leojpr770/CubeSat-UD34-Pr-ctica-3-de-Dise-o-de-productos/README.md

# CubeSat-UD34-Pr-ctica-3-de-Diseño-de-productos
Desarrollo de una satetile

Diagrama editables:
https://canva.link/5yh8kp0bcqomga4

### Actualizacion:
Se realizo la seleccion y la arquitecctura de la PCB OBS+ADCS, en el que se busco sus respectivos componentes y parametros. A partir de eso creamos un esquemeaticos con cierta secmentacion para cada tares de la PCB de forma jerarjica.
