leojpr770/CubeSat-UD34-Pr-ctica-3-de-Dise-o-de-productos/Hoja_de_datos.pdf

Table 1: Hojas de datos y fuentes t´ecnicas – CubeSat UD34, Pr´actica 3

Componente | Fabricante | Referencia /
modelo
Documento | Enlace

Sensor de imagen

OmniVision | OV5647 | Product datasheet (5
MP, 1.4 µm OmniBSI)

https://static.
sparkfun.com/
datasheets/Dev/
RaspberryPi/OV5647.
pdf (https://static.sparkfun.com/datasheets/Dev/RaspberryPi/OV5647.pdf)

Transceptor
UHF

onsemi (ex ON
Semiconductor)
AX5043 | Datasheet – Advanced
ASK/FSK/GFSK/MSK
Narrow-band
Transceiver

https://www.onsemi.
com/pdf/datasheet/
ax5043-d.pdf (https://www.onsemi.com/pdf/datasheet/ax5043-d.pdf)

Microcontrolador
(OBC)

STMicroelectronicsSTM32L4S5 / L4S7 / L4S9

Datasheet – Ultra-lowpower Arm Cortex-M4
MCU

https://st.
com/resource/
en/datasheet/
stm32l4s5ai.pdf (https://st.com/resource/en/datasheet/stm32l4s5ai.pdf)

Magnet´ometro
3 ejes

PNI Sensor Corporation

RM3100 | RM3100 & RM2100
Sensor Suite User Manual

https://wmsc.
lcsc.com/wmsc/
upload/file/pdf/
v2/lcsc/2001040306_
PNI-C464558_C464558.
pdf (https://wmsc.lcsc.com/wmsc/upload/file/pdf/v2/lcsc/2001040306_PNI-C464558_C464558.pdf)

IMU (giroscopio
+ aceler´ometro)
Bosch Sensortec | BMI088 | Datasheet – 6-axis IMU
de alto desempe˜no

https://www.
bosch-sensortec.com/
media/boschsensortec/
downloads/datasheets/
bst-bmi088-ds001.pdf (https://www.bosch-sensortec.com/media/boschsensortec/downloads/datasheets/bst-bmi088-ds001.pdf)

Celda de bater´ıa
Li-ion 18650
Panasonic | NCR18650B | Datasheet – especifi-
caciones y curvas de
carga/descarga

https://e2e.ti.com/
cfs-file/__key/
communityserver-discussions-components-files/ 196/
Panasonic-NCR18650B-datasheet.
pdf (https://e2e.ti.com/cfs-file/__key/communityserver-discussions-components-files/196/Panasonic-NCR18650B-datasheet.pdf)

Est´andar
mec´anico Cube-Sat
The | CubeSat
Program, | Cal
Poly SLO

CDS Rev. 13 CubeSat Design Specification

https://www.unoosa.
org/documents/pdf/
psa/hsti/KiboCUBE/
CubeSat_Design_
Specification.pdf (https://www.unoosa.org/documents/pdf/psa/hsti/KiboCUBE/CubeSat_Design_Specification.pdf)

1
