leojpr770/CubeSat-UD34-Pr-ctica-3-de-Dise-o-de-productos/Diagramas.pdf

Diagrama funcional de referencia (común a ambas alternativas)

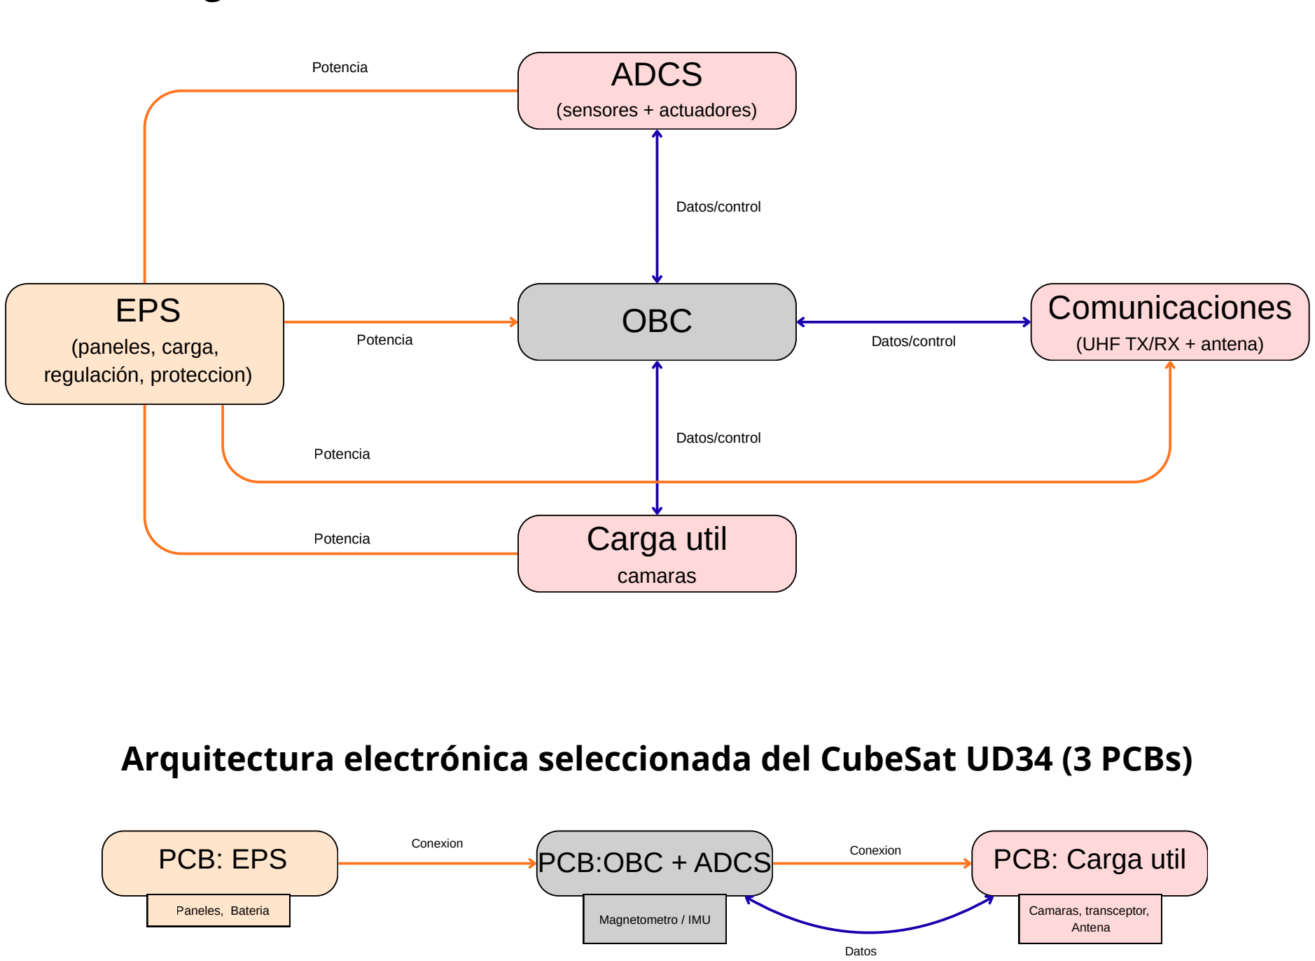
[picture p1: figure]
PCB: EPS; PCB:OBC + ADCS; PCB: Carga util; Paneles, Bateria; Camaras, transceptor,; Antena; Magnetometro / IMU; Datos Conexion; Conexion EPS; OBC; (paneles, carga, regulación, proteccion); Comunicaciones; (UHF TX/RX + antena); Datos/control Potencia; ADCS; (sensores + actuadores); Carga util; camaras; Potencia Potencia; Datos/control

Arquitectura electrónica seleccionada del CubeSat UD34 (3 PCBs)
