leojpr770/CubeSat-UD34-Pr-ctica-3-de-Dise-o-de-productos/Tablas_CubeSat.xlsx

Sheet: Requisitos
ID | Tipo | Requisito | Justificación | Prioridad | Criterio de aceptación
RF-01 | Funcional | El sistema deberá capturar imágenes en al menos 4 bandas espectrales (azul ~470 nm, verde ~550 nm, rojo ~660 nm, NIR ~850 nm). | Misión: análisis de vegetación cafetera (índices tipo NDVI) | Alta | Curvas de transmisión de los filtros y respuesta espectral del sensor en hoja de datos
RF-02 | Funcional | El sistema deberá producir imágenes con una distancia de muestreo en tierra (GSD) ≤ 20 m/píxel en nadir desde 550 km. | Misión: distinguir lotes/regiones, no plantas individuales | Alta | Cálculo GSD = (h × pixel_pitch)/f a partir de hoja de datos del sensor y la óptica
RF-03 | Funcional | El sistema deberá almacenar a bordo al menos 5 capturas multiespectrales completas antes de requerir descarga. | Disponibilidad de solo ~1 paso útil/día (S-02) | Alta | Cálculo de capacidad de memoria vs. tamaño de captura comprimida
RF-04 | Funcional | El hardware de actitud deberá permitir estimar la orientación y generar par de control suficiente para lograr apuntamiento nadir aproximado (≤ 5° en régimen estable). | Necesidad de apuntar la cámara a la Tierra | Alta | Verificación de rango dinámico de sensores y par máximo de actuadores vs. inercia estimada del 1U
RF-05 | Funcional | El sistema deberá transmitir telemetría (tensiones, corrientes, temperaturas, estado de subsistemas) en cada contacto con tierra. | Operación y supervisión | Alta | Trama de telemetría definida y verificable por radio de prueba en banco
RF-06 | Funcional | El sistema deberá recibir y decodificar comandos desde la estación terrestre (enlace de subida). | Operación remota | Alta | Prueba de recepción/decodificación en banco con transceptor de referencia
RF-07 | Funcional | El sistema de potencia deberá generar, almacenar, convertir y distribuir la energía necesaria para todos los subsistemas durante el ciclo órbita/eclipse. | Autonomía energética | Alta | Balance energético: generación orbital promedio ≥ consumo orbital promedio con margen ≥ 30 %
RF-08 | Funcional | El sistema de potencia deberá proteger los circuitos ante sobrecorriente, sobrecarga y descarga profunda de la batería. | Seguridad del hardware | Alta | Verificación de umbrales de protección en hoja de datos del IC de gestión de batería
RF-09 | Funcional | El sistema deberá permitir detumbling (reducción de velocidad angular) tras la separación del desplegador mediante los actuadores magnéticos seleccionados. | Condición inicial tras eyección | Media | Cálculo de par magnético disponible vs. velocidad angular típica de eyección (≤ 5°/s)
RF-10 | Funcional | El sistema deberá proveer una interfaz de programación/depuración accesible para cada microcontrolador antes de la integración final. | Facilidad de prueba e integración | Media | Presencia de conector/cabezal SWD o JTAG en cada tarjeta
RNF-01 | No funcional | El consumo promedio orbital del sistema no deberá superar el 70 % de la energía promedio generada. | Margen de diseño | Alta | Comparación de presupuesto de potencia
RNF-02 | No funcional | La potencia pico instantánea no deberá superar la capacidad de descarga continua de la batería seleccionada. | Protección de la batería | Alta | Comparación contra hoja de datos de la celda (corriente máx. de descarga)
RNF-03 | No funcional | El procesador central deberá tener margen de cómputo y memoria RAM ≥ 50 % sobre lo estimado para las tareas identificadas. | Evitar cuellos de botella para el software futuro | Media | Comparación de hoja de datos del MCU vs. estimación
RNF-04 | No funcional | La masa total de la electrónica (tarjetas, baterías, arnés) no deberá superar 500 g dentro del presupuesto de masa 1U. | Dejar margen para estructura, óptica y paneles | Media | Suma de masas estimadas por tarjeta
RNF-05 | No funcional | Cada PCB deberá encajar dentro del área útil de un 1U (aprox. 90 mm × 90 mm) respetando los rieles mecánicos. | Restricción mecánica del estándar CubeSat | Alta | Verificación dimensional del footprint de cada tarjeta
RNF-06 | No funcional | El enlace de comunicaciones deberá mantener un margen de enlace ≥ 3 dB en el peor caso (máxima distancia oblicua, elevación mínima de operación). | Confiabilidad del enlace | Alta | Cálculo del presupuesto de enlace
RA-01 | Ambiental | La electrónica deberá operar de forma continua en un rango de temperatura interna estimado entre -10 °C y +40 °C. | Ambiente térmico típico interno de un 1U sin control térmico activo | Media | Verificación del rango de temperatura de operación en hojas de datos de todos los componentes activos
RA-02 | Ambiental | Los componentes seleccionados deberán ser aptos para vacío (sin materiales con alto outgassing) en la medida de la información disponible del fabricante. | Ambiente de vacío en LEO | Media | Revisión de notas de aplicación/certificaciones de los fabricantes cuando existan
RA-03 | Ambiental | El sistema deberá incorporar un mecanismo de recuperación automática (watchdog + reinicio) ante fallos no catastróficos atribuibles al entorno de radiación. | Mitigación simplificada de radiación (sin calificación formal) | Media | Verificación de temporizador watchdog independiente en el diseño del OBC
RA-04 | Ambiental | La integración mecánica deberá seguir lineamientos generales de un desplegador tipo CubeSat (sujeción de tarjetas, ausencia de partes sueltas). | Cargas de lanzamiento (sin ensayo formal de vibración) | Baja | Revisión visual del modelo 3D contra lineamientos generales del estándar
RN-01 | Normativo | El CubeSat deberá respetar el sobre mecánico y el límite de masa de un 1U según la especificación de diseño CubeSat de referencia. | Compatibilidad con desplegadores estándar | Alta | Verificación dimensional y de masa contra el estándar de referencia
RN-02 | Normativo | El enlace de radiofrecuencia deberá operar en una banda permitida para el servicio de satélites de aficionados/experimental (p. ej. banda UHF 435--438 MHz), sujeto a coordinación de frecuencia. | Cumplimiento regulatorio de espectro | Alta | Verificación de la banda seleccionada contra la asignación vigente y evidencia de que se requiere coordinación
RN-03 | Normativo | La energía almacenada en la batería no deberá exceder los límites de seguridad típicamente exigidos por los desplegadores estándar para celdas de ion-litio comerciales. | Seguridad para el vehículo de lanzamiento | Media | Verificación de capacidad y tipo de celda contra el límite declarado por el estándar de referencia

Sheet: Especificaciones
ID | Requisito | Parámetro técnico | Valor, rango o tolerancia | Unidad | Fundamento | Método previsto de verificación
ET-01 | RF-01 | N.º de bandas espectrales y longitud de onda central | 470 / 550 / 660 / 850 | nm | Bandas típicas para índices de vegetación (visible + NIR) con filtros de interferencia comerciales | Hoja de datos de filtros + curva de respuesta del sensor
ET-02 | RF-01 | Ancho de banda de cada filtro | 20--40 | nm | Compromiso entre selectividad espectral y señal captada | Hoja de datos del filtro
ET-03 | RF-02 | Distancia focal del objetivo (sensor de 1.4 µm de pixel pitch) | ≈ 38.5 | mm | f = pixel_pitch × h / GSD = 1.4e-6×550000/20 | Cálculo geométrico + hoja de datos del sensor
ET-04 | RF-02 | Resolución del sensor de imagen | 2592 × 1944 (5 MP) | px | Disponibilidad comercial (sensor CMOS tipo OV5647) compatible con GSD objetivo | Hoja de datos del sensor
ET-05 | RF-02 | Ancho de franja (swath) en nadir | ≈ 51.8 | km | Swath = GSD × N_col = 20×2592 | Cálculo geométrico
ET-06 | RF-01, RF-03 | Tamaño de una captura multiespectral sin comprimir (4 bandas, 10 bits) | ≈ 25.2 | MB | (2592×1944×10bits/8)×4 | Cálculo aritmético
ET-07 | RF-03 | Tamaño de una captura comprimida (compresión ≈8:1 tipo JPG por banda) | ≈ 3.2 | MB | Relación de compresión típica sin pérdida perceptual relevante para el análisis previsto | Estimación basada en literatura de compresión de imagen satelital
ET-08 | RF-03 | Capacidad mínima de almacenamiento no volátil | ≥ 64 (objetivo 128) | MB | 5 capturas comprimidas (RF-03) + margen ≥100 % | Hoja de datos de memoria NAND seleccionada
ET-09 | RF-04 | Rango dinámico del magnetómetro / IMU | ±800 µT / ±2000 °/s | -- | Cubre el campo magnético terrestre en LEO y la velocidad angular esperada tras la eyección | Hoja de datos de los sensores seleccionados
ET-10 | RF-04, RF-09 | Momento magnético de los magnetotorquers | ≥ 0.2 | A·m² (por eje) | Suficiente para detumbling en <1 órbita con velocidad angular inicial ≤5°/s (estimación simplificada) | Cálculo de par magnético vs. inercia estimada del 1U (masa ≈1.3 kg)
ET-11 | RF-05, RF-06 | Tasa de enlace UHF (subida y bajada) | 9.6 / 38.4 | kbps | Compatible con transceptores UHF de bajo consumo típicos de CubeSat y con el presupuesto de enlace (RNF-06) | Presupuesto
ET-12 | RF-05, RF-06, RN-02 | Banda de frecuencia del enlace | 435--438 | MHz | Banda de uso frecuente en CubeSats académicos, sujeta a coordinación | Asignación de frecuencia / IARU
ET-13 | RF-07, RNF-01 | Generación de potencia promedio orbital estimada | ≈ 1.8 | W | Celdas GaAs body-mounted en 4 caras laterales, eficiencia 30 %, factor de incidencia e iluminación promedio | Cálculo del presupuesto de potencia
ET-14 | RF-07 | Capacidad de batería | 2S1P Li-ion 18650, ≈19 Wh | Wh | Cubre consumo pico (TX) y provee reserva para eclipse | Hoja de datos de la celda seleccionada
ET-15 | RF-08 | Umbral de protección de batería | sobretensión 4.25 V/celda, subtensión 2.8 V/celda, sobrecorriente según IC | V / A | Límites típicos de seguridad para celdas Li-ion 18650 | Hoja de datos del IC de gestión de batería
ET-16 | RNF-03 | Frecuencia de reloj y RAM del procesador central | ≥80 MHz, ≥256 KB RAM | -- | Margen ≥50 % sobre estimación | Hoja de datos del MCU seleccionado
ET-17 | RNF-04 | Masa estimada total de electrónica (3 tarjetas + batería + arnés) | ≈ 400 | g | Suma de masas por tarjeta, dentro del límite de 500 g (RNF-04) | Estimación por componente

Sheet: Funciones HW-SW
Función | Tipo | Recursos de hardware necesarios | Responsabilidad del software | Justificación
Captura de imagen multiespectral | Mixta | 4 sensores CMOS + óptica + filtros, interfaz digital (I2C config. / paralelo o CSI para datos), buffer de línea | Configurar exposición/ganancia, disparar captura sincronizada de las 4 bandas, transferir a memoria | La captura depende del sensor y su interfaz; la sincronización y el control de exposición son del software
Compresión y empaquetado de imagen | Mixta | MCU de payload con suficiente RAM/cómputo, acceso a memoria NAND | Ejecutar algoritmo de compresión (tipo JPG) y generar el archivo con metadatos | Se decide qué se comprime y cómo, pero requiere un procesador capaz de ejecutarlo en un tiempo razonable
Almacenamiento no volátil | Hardware | Memoria NAND/NOR con interfaz SPI, sistema de archivos simple | Gestionar el sistema de archivos, control de desgaste (wear leveling) | El almacenamiento físico es hardware; su gestión eficiente es responsabilidad del software
Adquisición de telemetría (V, I, T) | Hardware | ADC interno/externo, sensores de corriente y temperatura, multiplexado | Leer periódicamente, formatear trama de telemetría | Sensado es hardware; el formateo y la periodicidad las define el software
Determinación de actitud | Mixta | Magnetómetro, IMU (giroscopio+acelerómetro), sensores de sol gruesos | Ejecutar el algoritmo de estimación de actitud (p. ej. filtro complementario/Kalman) | El hardware entrega mediciones; el algoritmo de estimación no se implementa en el curso
Control de actitud (detumbling / apuntamiento grueso) | Mixta | Magnetotorquers + drivers de corriente (puente H) | Ejecutar la ley de control (p. ej. B-dot) y generar el comando de corriente | El hardware entrega el actuador y su interfaz de control; el algoritmo se implementa después
Gestión de energía y protección | Hardware | IC de carga/MPPT, IC de protección de batería, reguladores DC-DC | Supervisar umbrales y reportarlos en telemetría | La protección eléctrica primaria debe ser autónoma en hardware (independiente del software)
Comunicación (TT&C) | Mixta | Transceptor UHF, antena, interfaz digital SPI/UART con el OBC | Implementar el protocolo de enlace, cifrado/autenticación de comandos, cola de transmisión | El hardware modula/demodula; el protocolo y la seguridad son del software
Supervisión y recuperación ante fallos | Mixta | Temporizador watchdog independiente, líneas de reinicio por subsistema | Alimentar el watchdog, registrar el evento y decidir la secuencia de recuperación | El disparo del watchdog es autónomo en hardware; la política de recuperación es software

Sheet: Criterios Selección
Criterio | Peso | Alternativa A | Alternativa B | Justificación
Consumo de energía | 0.15 | 3 | 4 | B tiene menor consumo estático al usar un solo MCU; A añade el consumo del MCU de payload aunque de bajo duty-cycle
Masa | 0.10 | 3 | 4 | B usa menos componentes y una tarjeta menos
Complejidad de integración | 0.15 | 3 | 3 | A tiene más interfaces entre tarjetas que verificar, pero B tiene más riesgo de interferencia dentro de una misma tarjeta; se consideran equivalentes
Confiabilidad / tolerancia a fallos | 0.20 | 5 | 2 | A aísla fallos por subsistema; en B un fallo del único MCU compromete todo el satélite
Facilidad de prueba (testeabilidad) | 0.15 | 5 | 3 | A permite probar cada tarjeta de forma independiente antes de integrar
Integridad de señal / EMI | 0.15 | 4 | 2 | A separa físicamente RF/óptica analógica de la lógica digital pura del OBC; B las combina en una sola tarjeta
Costo estimado | 0.05 | 3 | 4 | B requiere menos componentes activos
Riesgo técnico global | 0.05 | 4 | 3 | A reduce el riesgo de un punto único de falla, a costa de mayor esfuerzo de integración
Total ponderado | 1.00 | 3.80 | 3.05

Sheet: Interfaces
ID | Origen | Destino | Función | Señal/protoc. | Caract. eléctricas prelim | Volumen | Observaciones
IF01 | PCB-1 (EPS) | PCB-2 (OBC) | Alimentación regulada lógica | Bus 3.3 V | 3.3 V ±5 %, Imax≈300 mA | -- | Desacoplar cerca de cada carga
IF02 | PCB-1 (EPS) | PCB-3 (Payload/Comm) | Alimentación regulada lógica + RF | Bus 3.3 V / bus batería sin regular | 3.3 V para lógica; 6--8.4 V directo para etapa TX | -- | Separar plano de retorno RF del digital
IF03 | PCB-1 (EPS) | PCB-2 (OBC) | Telemetría de potencia (V, I, T) | Analógica / I2C | 0--3.3 V, I2C 100 kHz | ~10 muestras/s | Aislar referencia analógica de conmutación
IF04 | PCB-2 (OBC) | PCB-3 (Payload) | Comando de captura y transferencia de imagen | SPI | 3.3 V lógico, 4 hilos (SCLK, MOSI, MISO, CS) | ≤3.2 MB por captura comprimida | Longitud de pista controlada, terminación si >10 cm
IF05 | PCB-2 (OBC) | PCB-3 (Comm) | Trama de telemetría / comandos de enlace | UART o SPI | 3.3 V lógico | 9.6--38.4 kbps efectivos | Requiere aislamiento de referencia frente a la etapa de RF
IF06 | PCB-2 (OBC) | Sensores (magnetómetro, IMU, sun sensors) | Lectura de actitud | I2C / SPI | 3.3 V lógico | ≤1 kHz por sensor | Bus compartido, direcciones únicas por dispositivo
IF07 | PCB-2 (OBC) | Magnetotorquers | Comando de par magnético | PWM + drivers puente H | Bus batería sin regular (6--8.4 V), Ipico≤300 mA/eje | -- | Requiere plano de retorno dedicado por el ruido de conmutación
IF08 | PCB-3 (Comm) | Antena | Señal de RF | Línea coaxial/microstrip 50 Ω | 435--438 MHz, PTX≤1 W | -- | Adaptación de impedancia y filtrado armónico
IF09 | Todas | Externo (banco de pruebas) | Programación/depuración | SWD/JTAG | 3.3 V lógico | -- | Un cabezal por tarjeta, accesible antes de integración final

Sheet: Presupuestos
Subsistema | P. nominal | P. pico | Ciclo de actividad | Energía/órbita | Masa | Volumen | Fuente
PCB-1 (EPS, overhead propio) | 0.15 W | 0.30 W | 100 % | 0.24 Wh | 50 g | 25 cm³ | Hoja de datos de ICs de conversión (pérdidas típicas ~5--10 %)
Batería (2×18650) | -- | -- | -- | (almacenamiento, no consumo) | 96 g | 21 cm³ | Hoja de datos de celda 18650
PCB-2 (OBC + sensores, base) | 0.15 W | 0.20 W | 100 % | 0.24 Wh | 35 g | 20 cm³ | Hoja de datos MCU + sensores en modo activo continuo
Magnetotorquers (pulsos) | -- | 0.50 W | 15 % | 0.12 Wh | 25 g | 15 cm³ | Estimación de corriente de bobina y ciclo de detumbling
PCB-3: cámaras + MCU payload | 0.02 W (reposo) | 0.60 W (captura) | 2 % | 0.03 Wh | 50 g | 40 cm³ | Hoja de datos de sensor de imagen (4 unidades)
PCB-3: transceptor UHF (RX) | 0.15 W | -- | 90 % | 0.78 Wh | 15 g | 8 cm³ | Hoja de datos del transceptor (modo recepción continua)
PCB-3: transceptor UHF (TX) | -- | 1.80 W | 10.4 % | 0.29 Wh | (incl. arriba) | (incl. arriba) | Hoja de datos del transceptor (modo transmisión)
Antena + estructura de despliegue | -- | -- | -- | -- | 15 g | 10 cm³ | Estimación por componente comercial
Arnés e interconexión | -- | -- | -- | -- | 40 g | -- | Estimación
Total |  |  |  | ≈1.70 Wh/órbita | ≈326 g | ≈139 cm³

Sheet: Presupuesto Datos
Fuente de datos | Datos por adquisición | Adquisiciones estimadas | Volumen acumulado | Almacenamiento requerido | Tasa mínima de transferencia
Captura multiespectral (4 bandas, comprimida) | ≈3.2 MB | 1/día (S-02) | ≈16 MB / 5 días (RF-03) | ≥64 MB (ET-08, con margen) | --
Telemetría de estado | ≈0.5 KB/muestra | 1 muestra/10 s ≈576/día | ≈0.29 MB/día | Incluido en margen de almacenamiento | 9.6 kbps (subida/bajada de estado)
Enlace de bajada (imagen + telemetría) | -- | -- | -- | -- | 38.4 kbps (ET-11), 1 captura (≈3.2 MB =25.6 Mb) en ≈11 min, compatible con la ventana de paso de S-02
