leojpr770/CubeSat-UD34-Pr-ctica-3-de-Dise-o-de-productos/Distribuidores.xlsx

Distribuidor | Componente | 10 unidades | 100 unidades | 1000 unidades | Enlace
Verical | OPA333AlDBVT | $5120 | $5120 | $5120 | https://www.verical.com/pd/texas-instruments-amplifier---operational-OPA333AIDBVT-223496
Newark | CGA2B3X7RIE104K050BB | $382.28 | $129.53 | $94.78 | https://www.newark.com/tdk/cga2b3x7r1e104k050bb/cap-0-1-f-25v-10-x7r-0402/dp/52W9616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
Newark | CC0603KRX7R7BB225 | $1482 | $664.50 | $492.38 | https://www.newark.com/yageo/cc0603krx7r7bb225/cap-mlcc-smd-2-2uf-16v-x7r/dp/25AM5658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
Arrow Electronics | CGAIA2COGIE220J030BA | $65.78 | $53.51 | $37.14 | https://www.arrow.com/en/products/cga1a2c0g1e220j030ba/tdk.html?region=global
Newark | C4532COG2E104J320KN | $6295 | $3488 | $2725 | https://www.newark.com/tdk/c4532c0g2e104j320kn/cap-0-1-f-250v-5-c0g-np0-1812/dp/68AC5031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
Newark | CC0603KRX5R6BB106 | $837.21 | $314.74 | $229.76 | https://www.newark.com/yageo/cc0603krx5r6bb106/cap-mlcc-smd-10uf-10v-x5r/dp/25AM5654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
Newark | C0603C105K4RACTU | $417.99 | $138.28 | $100.57 | https://www.newark.com/kemet/c0603c105k4ractu/cap-1-f-16v-10-x7r-0603/dp/27T5763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
1C Components Ltd. | CGA4JIX7TOJ226M125AC | $322.25 | $322.25 | $118.16 | octopart.com/opatz8j6/a1?t=ojt6nabuv7k47fWjp5GQ01Ot9TEx4n-Csj2up8z7f92_JRGL7e5upXE7U1H0WONwCo_YvZxkQXIWeMLcga2UEyqbEZ10khvafRz3cq7pk409fpApN63RLkAJUlPSUdkRO58f8E9pUaacyAQihgmKUK7vaJpHw4Cq7wMjktdwtfS5AnjWeIjNtr8fcsPy62S2bmDeCWmX6eg9aefVZbeRScT0GuNHGuxMDbbSb9TCScF5MV98in5hX4gS8rqIiLJ1Nj70eZm-vnv8Ci1XRQTzipC6sA
Mouser | 80-C0603C332J3GAUTO | $813.97 | $531.13 | $417.99 | https://www.mouser.com/es/ProductDetail/KEMET/C0603C332J3GACAUTO?qs=zDkSFN9STR9QXDuio8BbAg%3D%3D
Avnet | SMAJ5.OA | 1731 | $679.84 | $459.52 | https://www.avnet.com/americas/product/bourns/smaj50a/evolve-36575925/?CMP=afc-synd-avn-octo-buynow-invf
CoreStaff | ST73514449 | $199.64 | $199.64 | $213.71 | https://www.zaikostore.com/zaikostore/en/stockDetail?stockID=st73514449
Avnet Ü | SSW-125-01-L-D | $19664 | $19664 | $8347 | https://www.avnet.com/americas/product/samtec/ssw-125-01-l-d/evolve-4872629/?CMP=afc-synd-avn-octo-buynow-invf
Aztech | XFL4020-222MEB | $19077 | $19077 | $19077 | https://aztechwire.com/p/coilcraft/XFL4020-222MEB/18685730389245
Mouser | 936-MR25HIOMDF | $58990 | $54370 | $52578 | https://www.mouser.com/es/ProductDetail/Everspin-Technologies/MR25H10MDF?qs=laR3Dyet2VcNYa4bxoHu%252BQ%3D%3D
Powell Europe | FTSH-105-01-L-DV | $3980 | $4087 | $3860 | https://powell-europe.com/product/Samtec-FTSH-105-01-L-DV
Powell Europe | TSW-102-08-L-S-RA | $691.41 | $754.26 | $597.12 | https://powell-europe.com/product/Samtec-TSW-102-08-L-S-RA
Newark | CRCW080510KOFKEA | $314.28 | $78.57 | $56.57 | https://www.newark.com/vishay/crcw080510k0fkea/chip-res-smd-10k-1-125mw/dp/68AH8357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
Avnet | WSLP0805R0500FEA | $3162 | $1468 | $1169 | https://www.avnet.com/americas/product/vishay/wslp0805r0500fea/evolve-36578686/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
Newark | CRCW0603316KFKEA | $317.64 | $50.82 | $28.59 | https://www.newark.com/vishay/crcw0603316kfkea/d11-crcw0603-100-316k-1-percent/dp/13AN2365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
TME | STM32H742ZlT6 | $61.19 | 59.775 | $43.97 | https://www.tme.eu/en/details/stm32h742zit6/st-microcontrollers/stmicroelectronics/
Mouser | 595-TPS7A4701MRGWREP | $39.95 | $34.73 | $32.19 | https://www.mouser.com/es/ProductDetail/Texas-Instruments/TPS7A4701MRGWREP?qs=yBt6ao%2FxsTwnFjrWAtMx9Q%3D%3D
weyland Electronics Group Pte. Ltd. Ü | TPS62130RGTT | $1080 | $1080 | $1080 | https://www.weylan-d.com/goods/detail/4407024/
Arrow Electronics | DRV8837DSGR | $2538 | $1990 | $1612 | https://www.arrow.com/en/products/drv8837dsgr/texas-instruments.html?region=nac
Esaler Electronic | BMM150 | $2847 | $2796 | $2771 | https://www.elecsaler.com/product/bosch-sensortec/bmm150-9005053
DigiKey | 256-W25N01GVZElGTRCT-ND | $56530 | $52170 | $49111 | https://www.digikey.com/en/products/detail/winbond-electronics/W25N01GVZEIG-TR/7393545?curr=cop
