leojpr770/CubeSat-UD34-Pr-ctica-3-de-Dise-o-de-productos/BOM.png

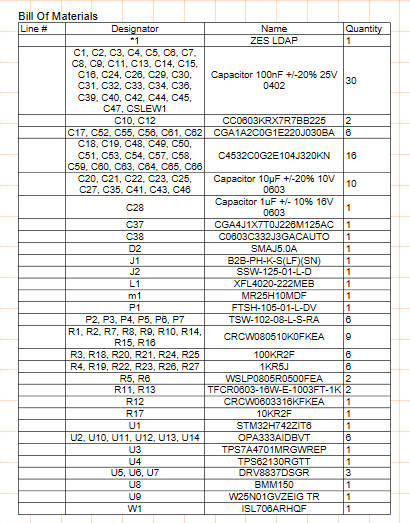
BOM.png
