leojpr770/CubeSat-UD34-Pr-ctica-3-de-Dise-o-de-productos/datasheets/memoria/ul_W25N01GVZEIG/Altium/W25N01GVZEIG/WSON-8_8X6_WIN.step

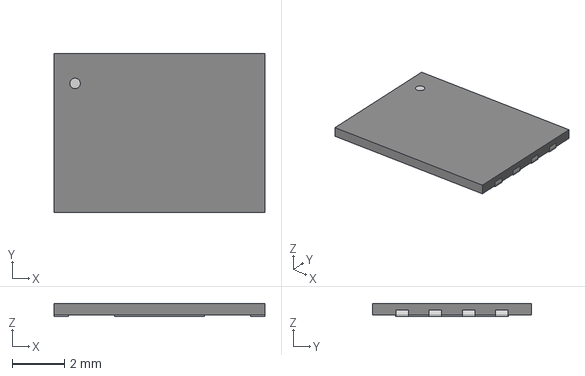
[picture p3: CAD file, 2026-10-18]
datasheets/memoria/ul_W25N01GVZEIG/Altium/W25N01GVZEIG/WSON-8_8X6_WIN.step
8.10 x 6.10 x 0.485 mm
