leojpr770/CubeSat-UD34-Pr-ctica-3-de-Dise-o-de-productos/datasheets/Procesador/ul_STM32H742ZIT6/AltiumDesigner/LQFP144-20x20mm.step

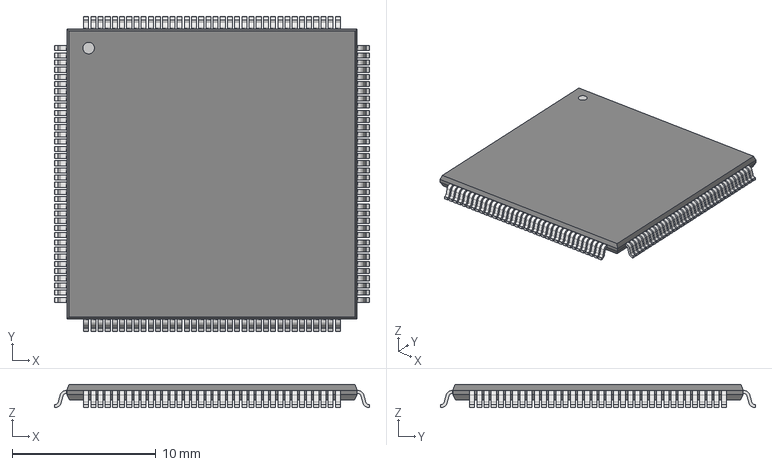
[picture p4: CAD file, 2026-10-18]
datasheets/Procesador/ul_STM32H742ZIT6/AltiumDesigner/LQFP144-20x20mm.step
21.9 x 21.9 x 1.60 mm
