leojpr770/CubeSat-UD34-Pr-ctica-3-de-Dise-o-de-productos/(list of files, cad)

Other CAD files:
ul_STM32H742ZIT6/Altium/LQFP144-20x20mm.step
