leojpr770/CubeSat-UD34-Pr-ctica-3-de-Dise-o-de-productos/Squematics Altium.pdf

REVISION | DESCRIPTION | DATE | APPROVED | REV. SHT. <SCH DWG NO> 1 DWG. NO.

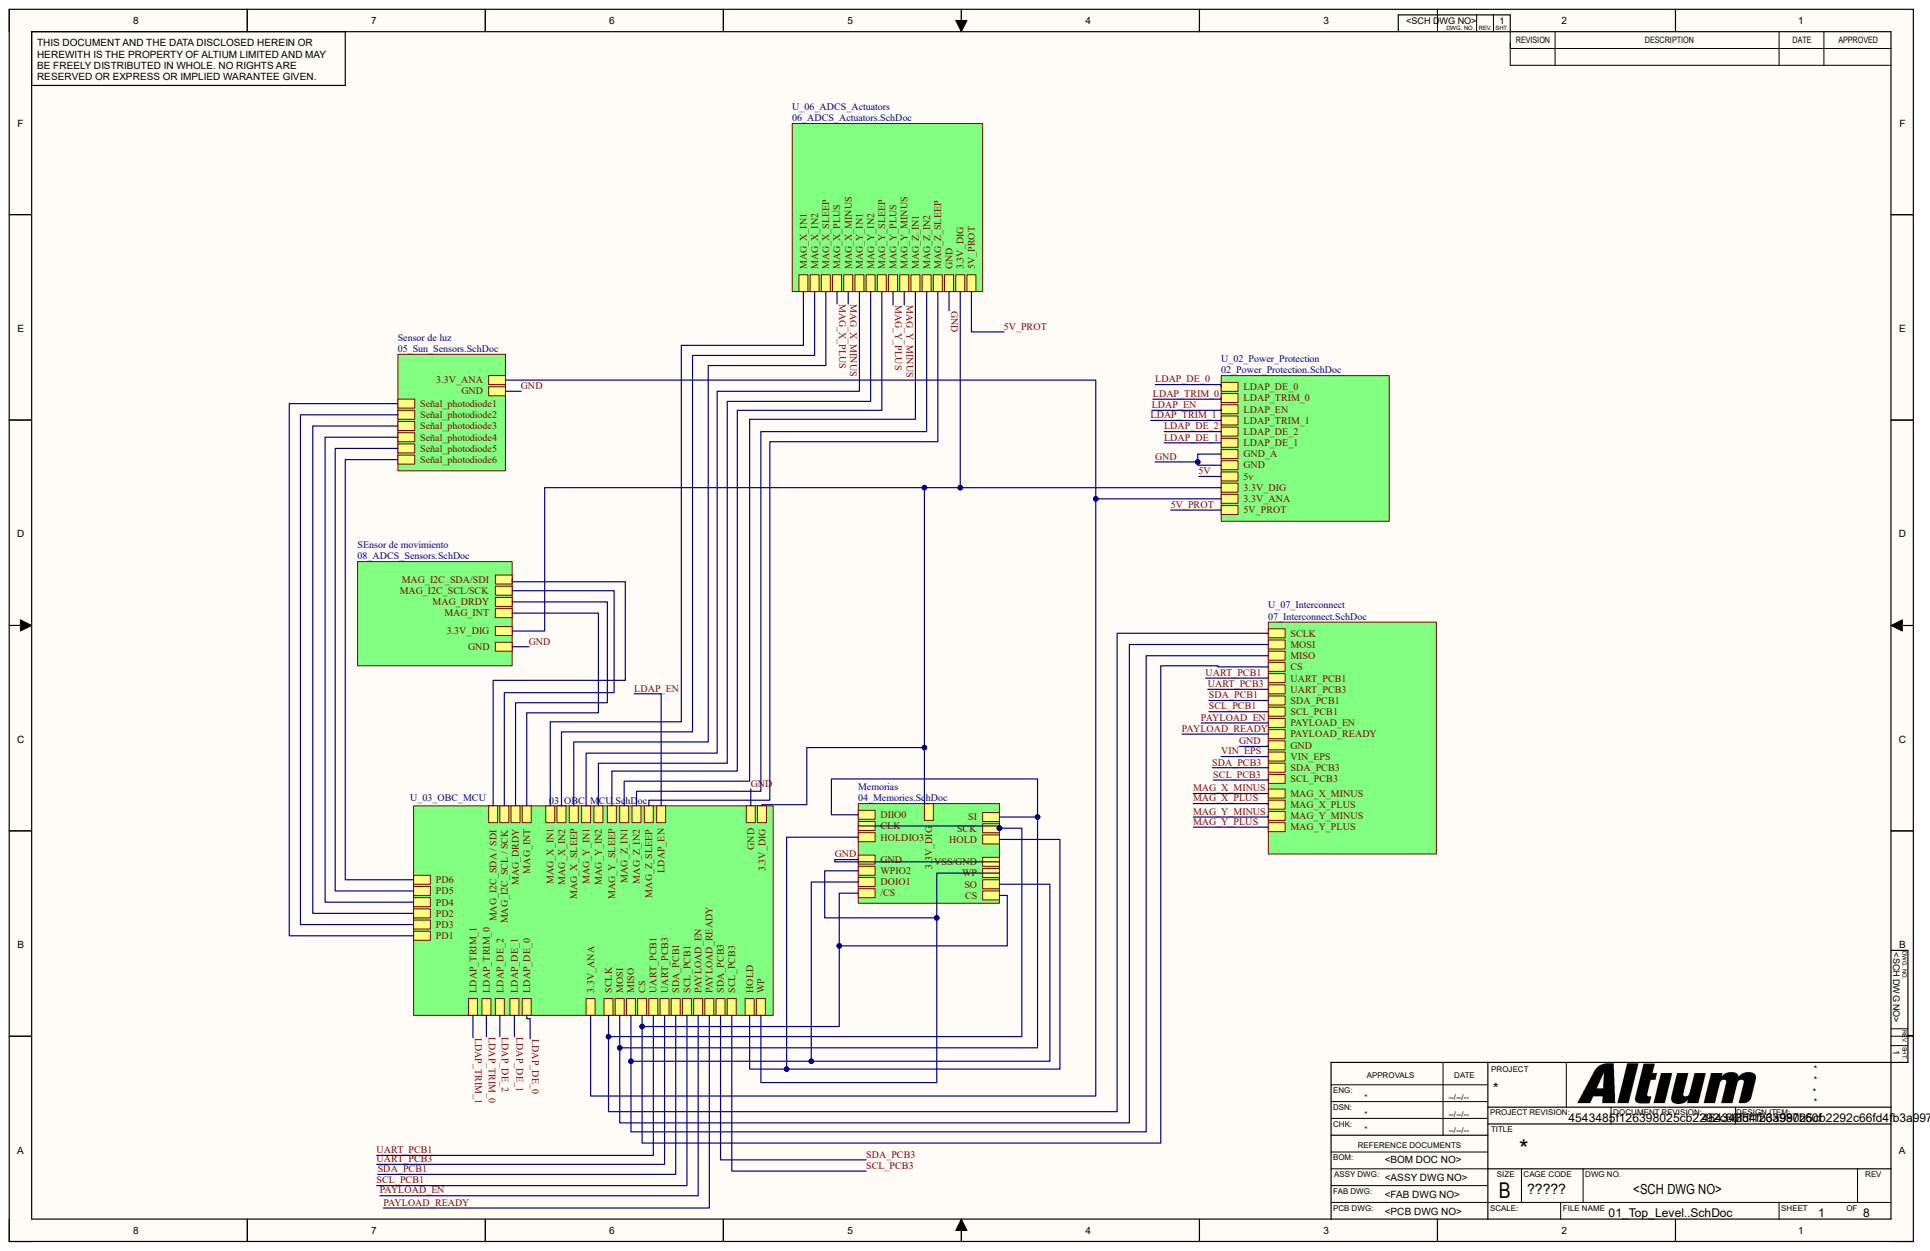
[picture p5: page 1]
01_Top_Level..SchDoc; SIZE; DWG NO.; FILE NAME; SHEET; REV; SCALE:; CAGE CODE; REFERENCE DOCUMENTS; BOM:; ASSY DWG:; FAB DWG:; PCB DWG:; <PCB DWG NO>; PROJECT REVISION:; DOCUMENT REVISION:; DESIGN ITEM: 4543485f126398025cb2292c66fd4fb3a997b60f 4543485f126398025cb2292c66fd4fb3a997b60f; GND; 3.3V_ANA; Señal_photodiode1 Señal_photodiode2 Señal_photodiode3 Señal_photodiode4 Señal_photodiode5 Señal_photodiode6; MAG_INT; MAG_DRDY; MAG_I2C_SCL/SCK; MAG_I2C_SDA/SDI; 3.3V_DIG; VSS/GND; HOLD; SCK; DOIO1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

8 | 7 | 6 | 5 | 4 | 3 | <SCH DWG NO> | DWG. NO. | REV. | 1 SHT. | 2 | 1

THIS DOCUMENT AND THE DATA DISCLOSED HEREIN OR HEREWITH IS THE PROPERTY OF ALTIUM LIMITED AND MAY BE FREELY DISTRIBUTED IN WHOLE. NO RIGHTS ARE RESERVED OR EXPRESS OR IMPLIED WARANTEE GIVEN. | U_06_ADCS_Actuators

Sensor de luz
05_Sun_Sensors.SchDoc

SEnsor de movimiento
08_ADCS_Sensors.SchDoc

APPROVALS | DATE | PROJECT * | * *

ENG: * | --/--/--
CHK: * | --/--/-- | TITLE *

DSN: * | --/--/--

<BOM DOC NO>
<ASSY DWG NO>
<FAB DWG NO>

B <SCH DWG NO>

C1 1 2
C2 1 2

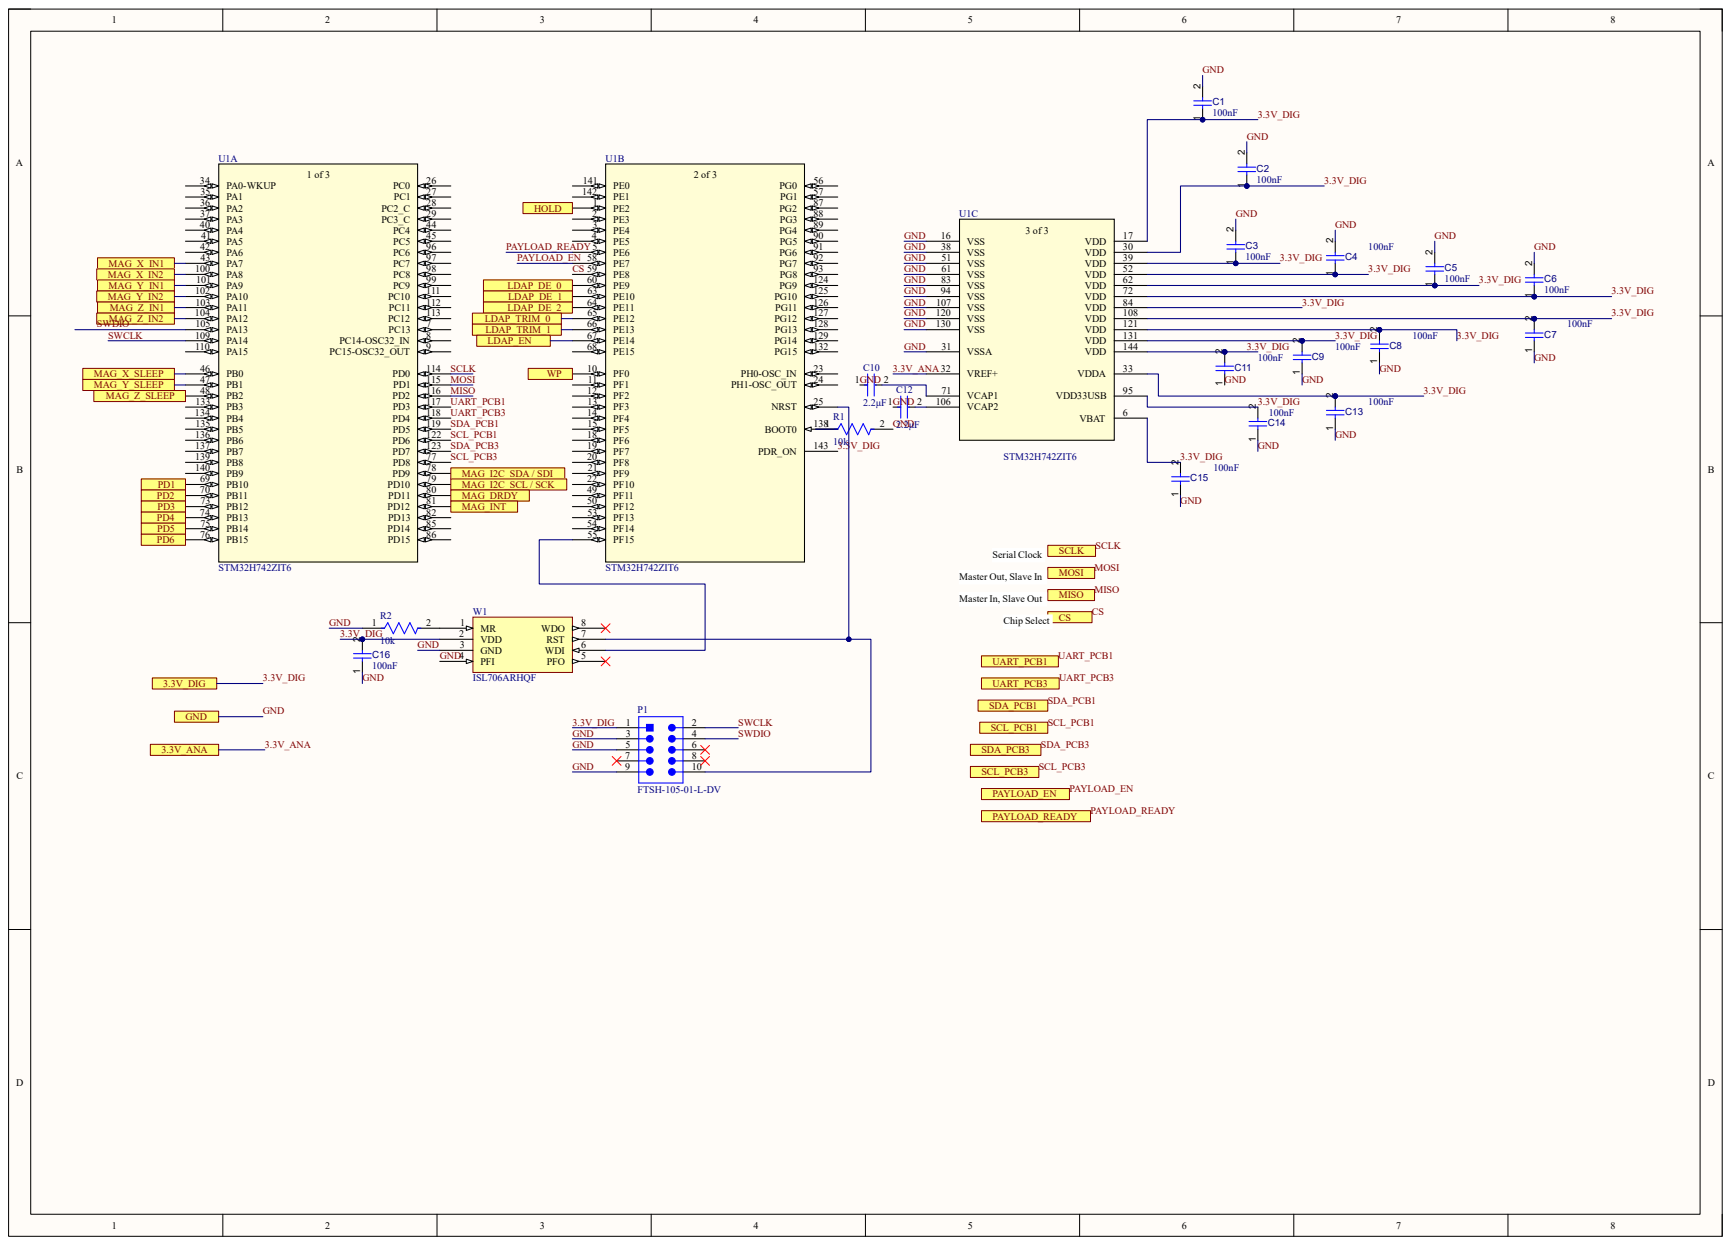
[picture p6: page 2]

Master Out, Slave In

Master In, Slave Out

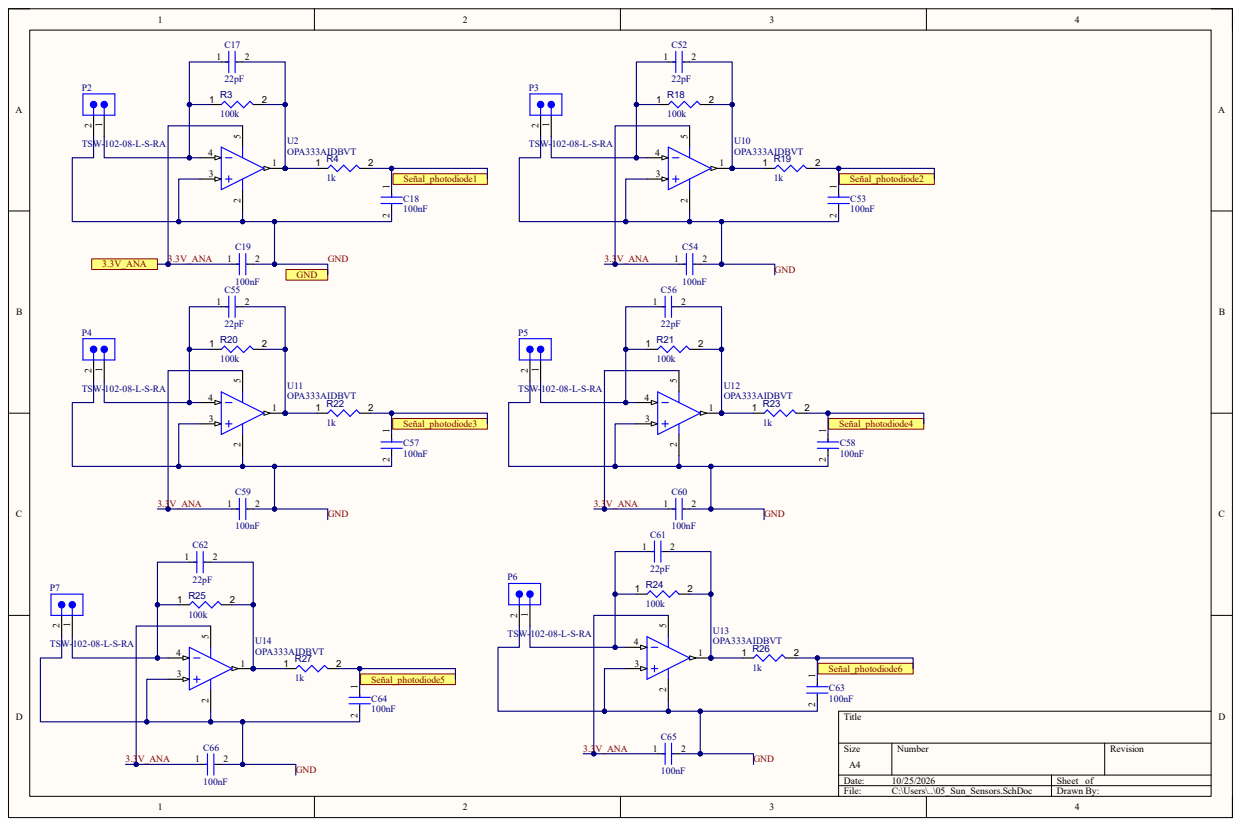
[picture p7: page 3]

C28 1 2
C21 1 2

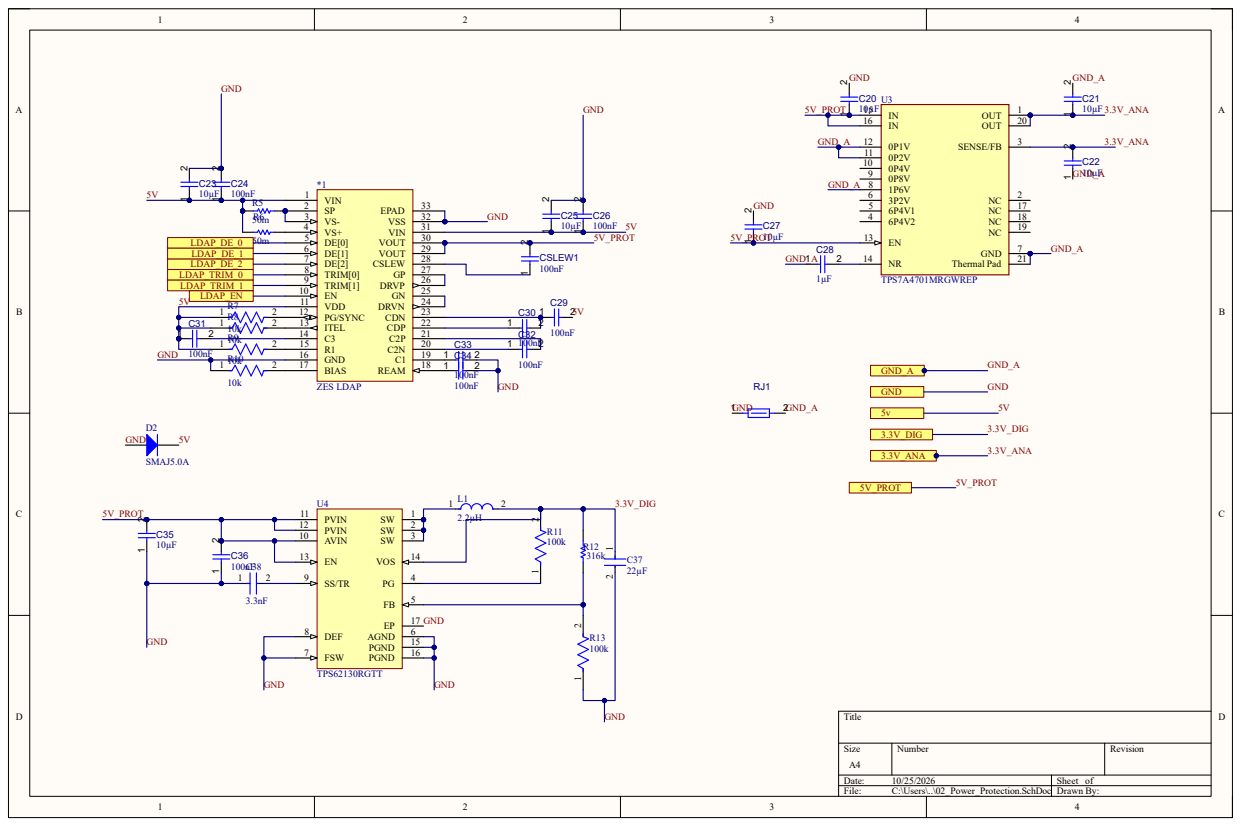
[picture p8: page 4]

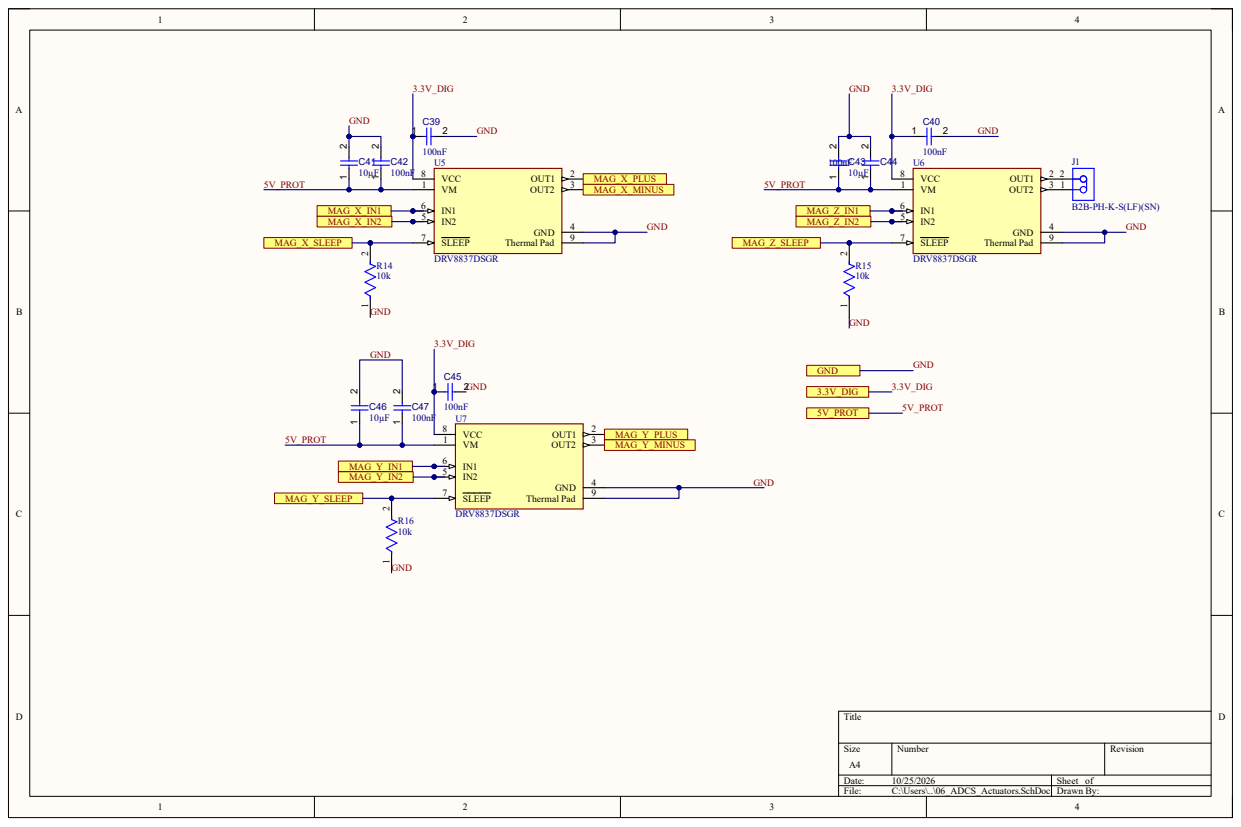
[picture p9: page 5]

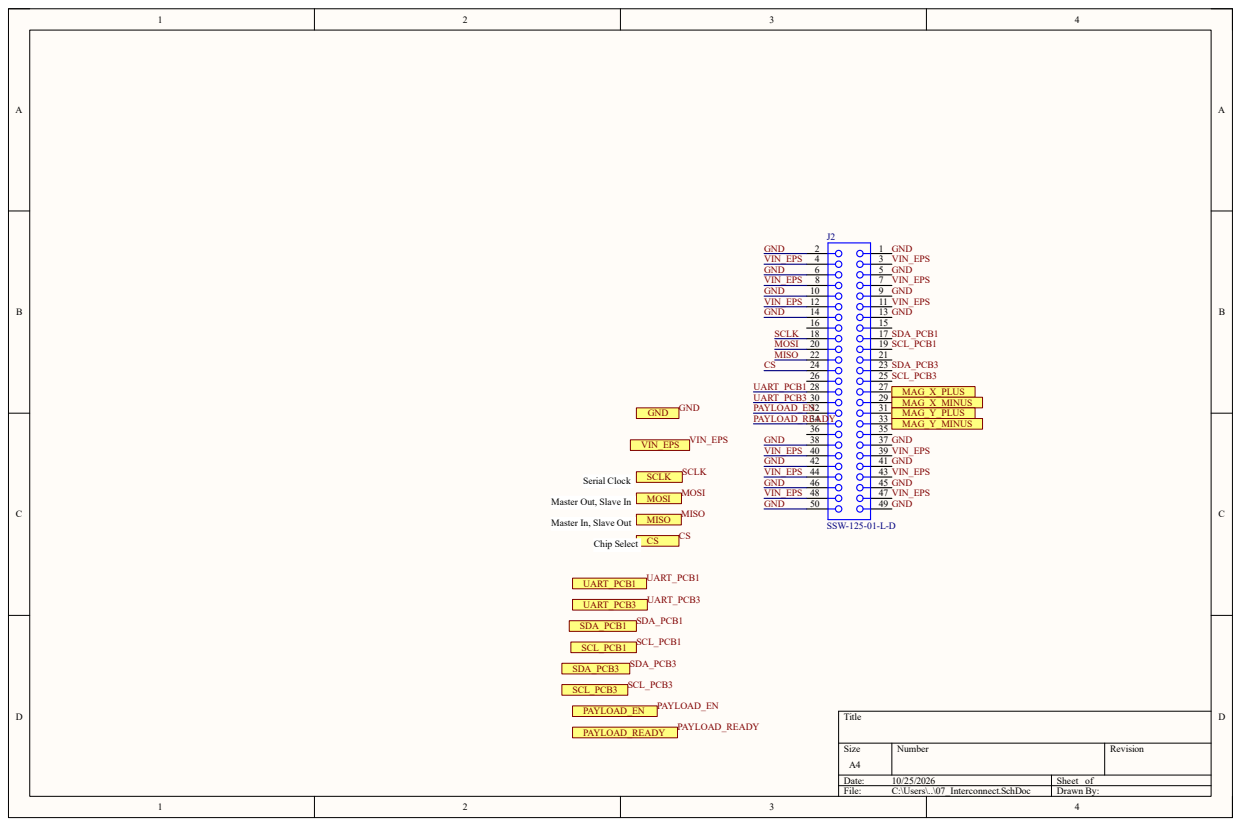
[picture p10: page 6]
Title; Size; Number; Revision; Date:; Sheet of; File:; C:\Users\..\07_Interconnect.SchDoc; Drawn By: 13579; SSW-125-01-L-D; SCLK; MOSI; MISO; UART_PCB1; UART_PCB3; SDA_PCB1; SCL_PCB1; PAYLOAD_EN; PAYLOAD_READY; GND; VIN_EPS; Serial Clock; Chip Select; SDA_PCB3; SCL_PCB3; SCLK MOSI MISO CS; UART_PCB1 UART_PCB3 PAYLOAD_EN PAYLOAD_READY; SDA_PCB1 SCL_PCB1; SDA_PCB3 SCL_PCB3 MAG_X_PLUS MAG_X_MINUS MAG_Y_PLUS MAG_Y_MINUS

Master Out, Slave In

Master In, Slave Out

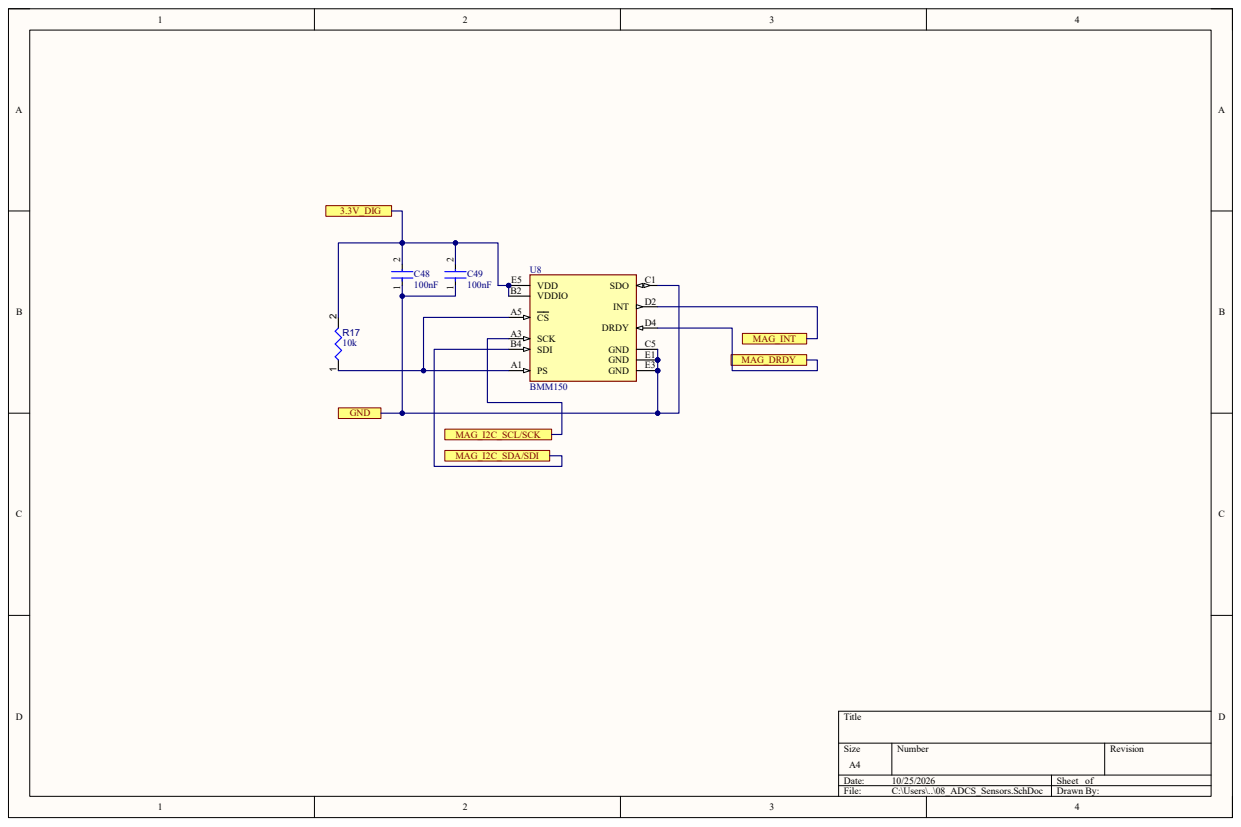
[picture p11: page 7]

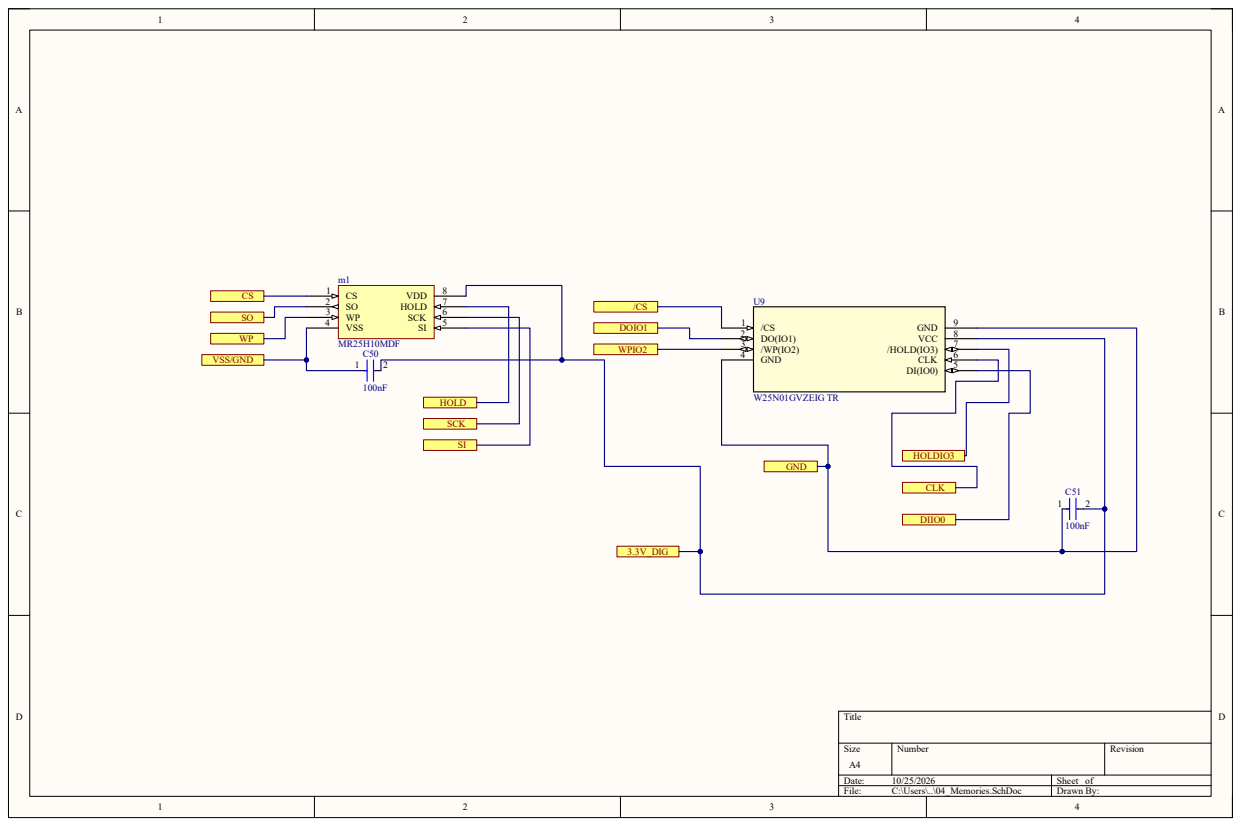
[picture p12: page 8]
Title; Size; Number; Revision; Date:; Sheet of; File:; C:\Users\..\04_Memories.SchDoc; Drawn By:; VSS 4; SCK; HOLD; VDD; MR25H10MDF; /CS 1 DO(IO1) 2 /WP(IO2) 3 GND 4; CLK; /HOLD(IO3); VCC; GND; W25N01GVZEIG TR; DOIO1; WPIO2; 3.3V_DIG; HOLDIO3; DIIO0; VSS/GND
