leojpr770/CubeSat-UD34-Pr-ctica-3-de-Dise-o-de-productos/(list of files, drawings)

Other design files:
datasheets/memoria/Altium/W25N01GVZEIG/W25N01GVZEIG.SchLib
datasheets/memoria/ul_W25N01GVZEIG/Altium/W25N01GVZEIG/W25N01GVZEIG.PcbLib
datasheets/Procesador/ul_STM32H742ZIT6/AltiumDesigner/STM32H742ZIT6.PcbLib
datasheets/Procesador/ul_STM32H742ZIT6/AltiumDesigner/STM32H742ZIT6.SchLib
ul_STM32H742ZIT6/Altium/STM32H742ZIT6.PcbLib
ul_STM32H742ZIT6/Altium/STM32H742ZIT6.SchLib
