leojpr770/CubeSat-UD34-Pr-ctica-3-de-Dise-o-de-productos/(commit log)

2026-10-14 datasheets de componentes de seguridad y memoria
2026-10-15 actuadores (el puente H está en veremos)
